Keerthi-2012/Audio-Amplifier/2023102012_2023112002_Table17.pdf

XXX-X-XXXX-XXXX-X/XX/$XX.00 ©20XX IEEE

# Audio Amplifier

KEERTHI SEELA
2023102012
IIIT HYDERABAD
keerthi.seela@students.iiit.ac.in

ANUMULA VENKATA SAI SREE
SAHITHI
2023112002
IIIT HYDERABAD
sahithi.anumula@research.iiit.ac.in

Abstract—This project aims to design and implement an audio amplifier with the given specifications, performance criteria. The amplifier consists of four main stages: preamplification, gain stage, filtering, and power amplification. The pre-amplifier is designed using a differential common-emitter configuration to ensure high input impedance and minimize noise. The gain stage employs a common-emitter amplifier to achieve the required amplification. A band-pass filter is incorporated to limit unwanted frequency components while maintaining signal integrity. The power amplifier, implemented as a Class AB design, ensures efficient power delivery with minimal distortion. The project also includes an analysis of distortion and slew rate to evaluate signal quality and circuit performance. The total harmonic distortion (THD) is minimized using filtering techniques, while the slew rate is optimized to handle high-frequency signals effectively. The final design provides a robust and efficient audio amplification system suitable for various applications.

Keywords—component, formatting, style, styling, insert (key words)

I. INTRODUCTION
Amplifiers are essential in modern audio systems, ensuring weak signals are amplified without significant distortion. An ideal audio amplifier should not only increase signal strength but also maintain clarity, efficiency, and minimal noise. This project explores the design and implementation of an audio amplifier tailored for low-power applications while meeting key performance criteria.

The amplifier design is structured into multiple stages, each playing a critical role in enhancing the input signal. The pre-amplifier boosts the weak audio signal while maintaining a high signal-to-noise ratio. The gain stage provides the necessary amplification, while a band-pass filter ensures that only the desired frequency range (20 Hz–20 kHz) is retained. The final stage, a Class AB power amplifier, delivers sufficient power to drive the output without introducing significant distortion.

II. SPECIFICATIONS
The audio amplifier is designed to meet the following technical specifications:
- Supply Voltage: 0–5V
- Input Signal Voltage: 10–40mV (peak-to-peak)
- Voltage Gain: 500 (achieved through preamplification and gain stages)
- Frequency Response: 20 Hz to 20 kHz (audible frequency range)
- Output Power: 1.5W
- Filter Design: Must preserve the input signal without attenuation
- Power Amplifier Constraint: Should not introduce additional voltage gain
- Load Resistance: 10Ω
These specifications ensure that the amplifier effectively enhances low-level audio signals while maintaining signal integrity, minimizing distortion, and optimizing power efficiency.
template for your paper size. This template has been tailored for output on the A4 paper size. If you are using US letter-sized paper, please close this file and download the Microsoft Word, Letter file.

III. PRE-AMPLIFIER
A pre-amplifier (preamp) is the first stage in an audio amplifier system. Its main function is to increase the strength of a weak input signal so that it can be further amplified without distortion. In this project, the preamp is designed to handle input signals between 10–40mV peak-topeak while minimizing noise.
To ensure proper operation, the preamp should have a high input impedance to avoid drawing too much current from the signal source and a low output impedance to efficiently transfer the signal to the next stage. A common-emitter differential amplifier is chosen for its ability to provide high gain and reduce unwanted noise. Proper transistor biasing is necessary to keep the amplifier in its active region and prevent signal distortion.
A well-designed preamp helps maintain signal clarity by reducing interference and ensuring the input signal is amplified without unwanted modifications. Once the preamp boosts the signal, it is sent to the next stage for further amplification.

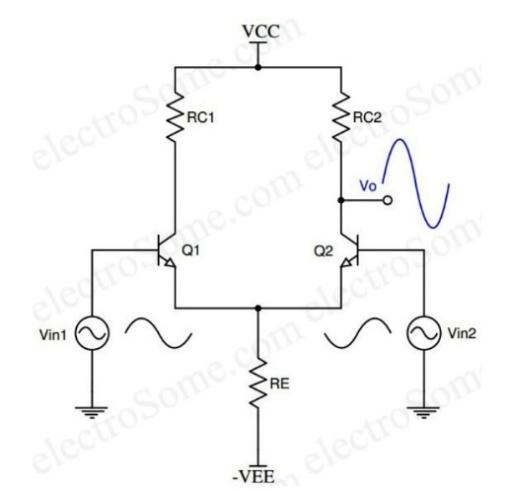
[picture p1: figure]

Figure: Pre-Amplifier

The differential amplifier is a fundamental building block in analog electronics, widely used in operational amplifiers and signal processing applications. It amplifies the difference between two input signals while rejecting common-mode noise. This report analyzes the working of a differential amplifier when one of its inputs Vin2 is grounded.
The circuit consists of two identical NPN transistors Q1 and Q2 with a common emitter resistor RE. The collectors are connected to the power supply VCC via resistors RC1 and RC2, and the output voltage Vo is taken from the collector of Q2. The input signals Vin1 and Vin2 are applied at the bases of the transistors, and the circuit operates with a negative power supply -VEE at the emitter resistor.
Biasing and DC Operation:
When Vin2=0 (grounded), the base-emitter voltage of Q2 is determined as:

VE = VB2 -VBE2 = 0V - 0.7V = -0.7V

The emitter current IE is given by:

IE = |VE- (-VEE) | / RE

Since IE is shared between Q1 and Q2,

IE1 + IE2 = IE

where IE1 and IE2 are the emitter currents of Q1 and Q2, respectively.

Effect of Input Voltage Vin1 on Transistor Currents:
When Vin1 increases:
- The base-emitter voltage VBE1 of Q1 increases, leading to an increase in IE1.
- Since the total emitter current IE remains nearly constant, an increase in IE1 results in a decrease in IE2.
- Since collector current IC is approximately equal to the emitter current in active mode, we get:
Output Voltage Behavior:
The output voltage Vo is taken from the collector of Q2 and is given by:
Vo = VCC - IC2 RC

As IC2 decreases with an increasing Vin1, the voltage drop across RC decreases, leading to an increase in Vo. This indicates that the circuit behaves as an inverting amplifier.

Voltage Gain of the Amplifier:
The voltage gain Av of the amplifier is determined by the transconductance gm and collector resistance RC:

gm = IC/ VT, Av = gm RC

where VT is the thermal voltage VT = 25mV at room temperature.

When Vin2 is grounded, the differential amplifier functions as a single-ended inverting amplifier. The output voltage increases when the input Vin1 increases, and the voltage gain depends on the transconductance and the collector resistance. This configuration is widely used in differential signal processing and operational amplifier designs.

Applications:
- Operational amplifier input stages
- Signal amplification and processing
- Common-mode noise rejection
- Comparator circuits

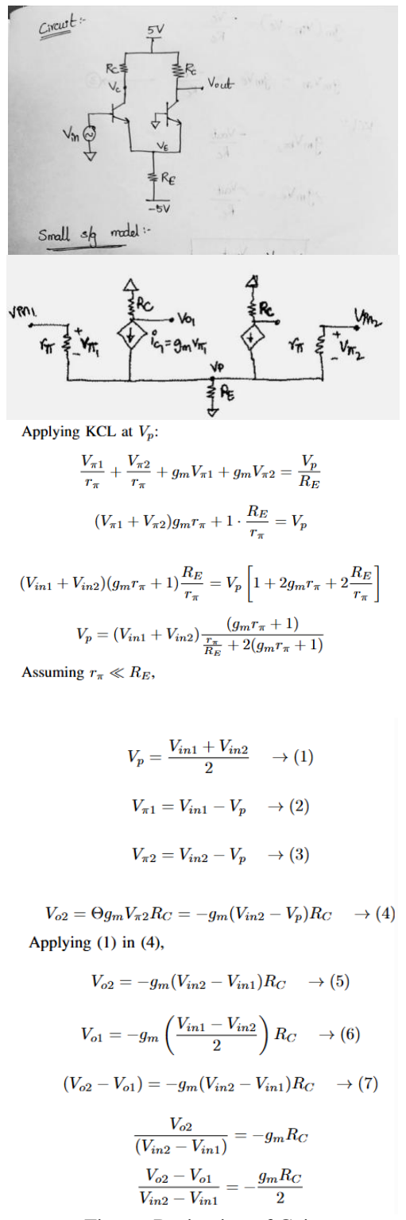
[picture p2: figure]

Figure: Derivation of Gain

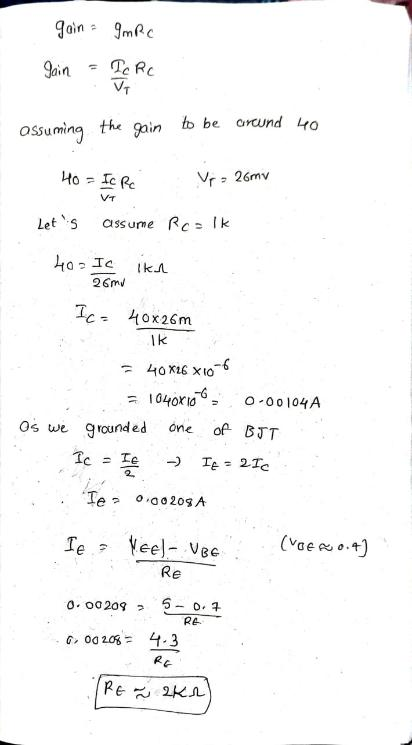
[picture p3: figure]

Figure: Calculations for pre-amplifier

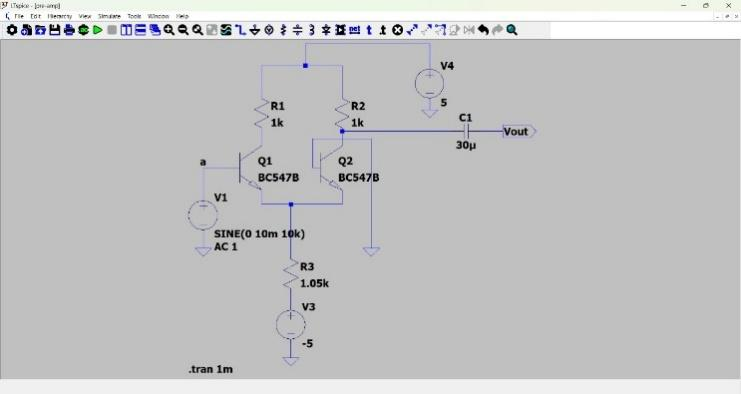
[picture p4: figure]

Figure: Circuit Diagram

Figure: LTSPICE Output

Figure: Bode plot

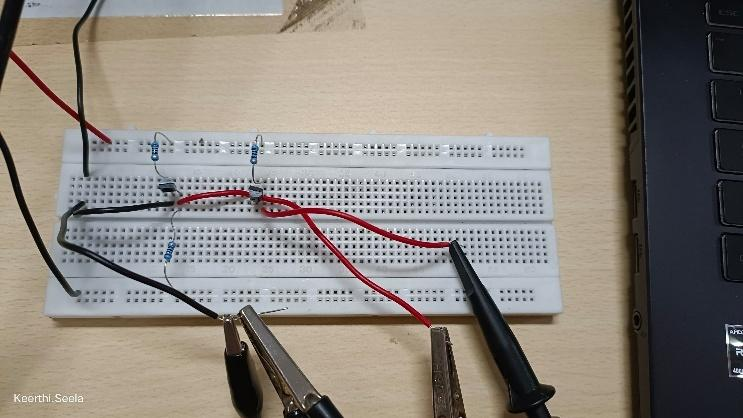
[picture p5: figure]

Figure: Hardware

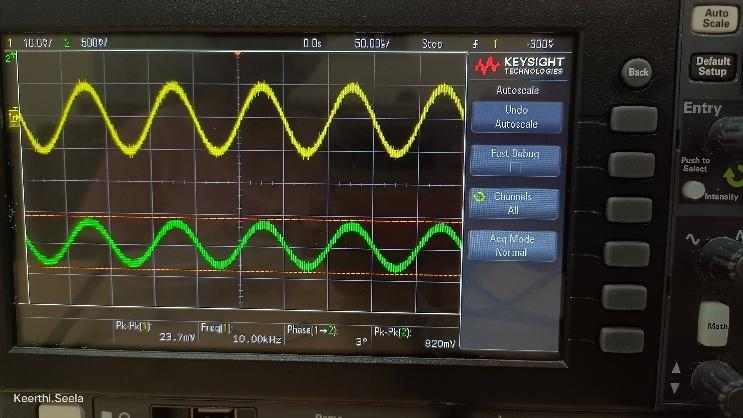
[picture p6: figure]

Figure: Hardware Output
Hardware Gain of preamp stage = 820 mV/20mV =41

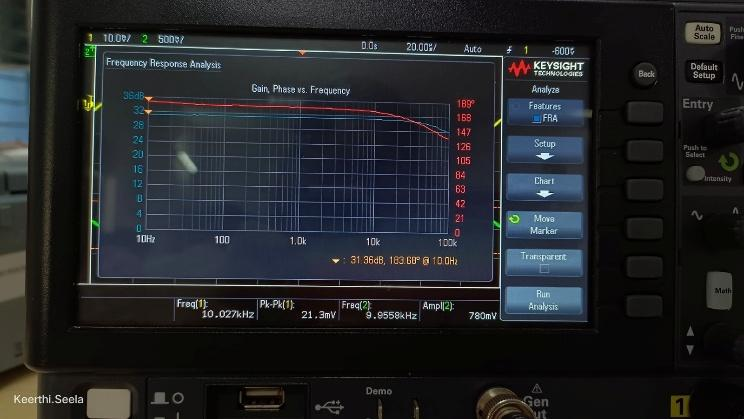
[picture p7: figure]

Figure: Hardware Bode Plot

Common mode Rejection Ratio:
Common-Mode Rejection Ratio (CMRR) is a measure of a differential amplifier’s ability to reject common-mode signals (noise) while amplifying differential signals. A higher CMRR indicates better noise rejection, making the amplifier more effective in reducing interference. The mathematical expression for CMRR is given by:
CMRR =

Ad

ACM
where:
- Ad = Differential Gain (gain for the desired signal)
- Acm = Common-Mode Gain (gain for noise or unwanted signals)
In decibels (dB), CMRR is expressed as:
CMRR(dB) = 20log10 (

|Ad

|Acm|

)

Example: (CMRR = 10,000)
If CMRR is 10,000, it means the amplifier amplifies the differential signal 10,000 times more than the unwanted noise.
In decibels:
CMRR = 20 log10(10, 000) = 80 dB
This indicates that the amplifier significantly reduces noise and interference, ensuring clean signal amplification. Stability Factor in Audio Amplifiers:
The stability factor in audio amplifiers measures how stable the amplifier is against changes in parameters, particularly temperature variations and component aging. It is crucial because unstable amplifiers can lead to unwanted effects like thermal runaway, oscillations, or distorted output.
a) Definition: The stability factor (S) quantifies how
much the collector current (IC) changes with changes in current gain (β). It is commonly defined as:

S =

dIC
dβ
The ideal value of S is 1, which indicates no change in collector current despite variations in β. Higher values indicate less stability.
Stability Important in Audio Amplifiers because:
- Temperature Variations:
- Amplifiers generate heat during operation, causing changes in transistor parameters, especially (β).
- A high stability factor can cause thermal runaway, leading to distorted audio output or damage to the amplifier.
- Component Aging:
- As components age, their parameters may change, particularly transistors and capacitors.
- An amplifier with a low stability factor is more robust against these changes.
- Feedback and Stability:
- Audio amplifiers often use negative feedback to improve stability and reduce distortion.
- Proper feedback design reduces the sensitivity of the output to variations in transistor parameters.

IV. GAIN STAGE
The gain stage is responsible for further amplifying the signal received from the pre-amplifier to achieve the required total gain of 500. This stage must be designed carefully to ensure signal integrity while minimizing distortion and instability.
A common-emitter (CE) amplifier is used due to its high voltage and current gain. It has a low input impedance, allowing efficient signal reception, and a high output impedance, making it suitable for driving the next stage.

To ensure stable operation, biasing resistors keep the transistor in its active region, preventing signal distortion. Coupling capacitors remove unwanted DC components, allowing only AC signals to pass. Additionally, proper impedance matching is necessary to ensure efficient signal transfer between stages, preventing signal loss and unwanted reflections that could degrade performance.

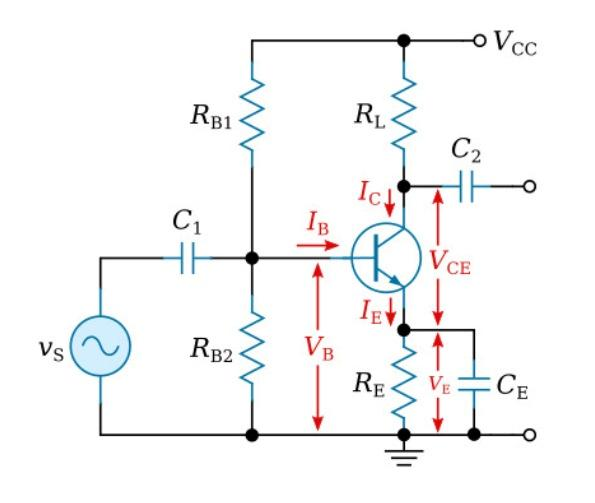
[picture p8: figure]
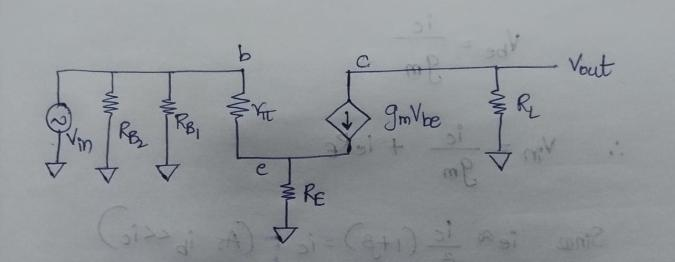
[picture p9: figure]

Figure: CE-Amplifier

Key Components of CE Amplifier:

The CE amplifier consists of the following key components:

- Biasing Resistors (RB1, RB2):
- Provide proper DC biasing to set the transistor's operating point.
- Emitter Resistor (RE):
- Stabilizes the operating point and improves linearity.
- Collector Resistor (RL):
- Converts the amplified current into an output voltage.
- Coupling Capacitors (C1, C2):
- Block DC and allow AC signals to pass.
- Bypass Capacitor (CE):
- Enhances gain by bypassing AC signal currents around RE.
- Power Supply (VCC):
- Provides the necessary operating voltage. Input and Output Impedance:
The CE amplifier exhibits moderate input impedance (typically 1-10 k) and relatively high output impedance (10-50 k).The input impedance is given by:
Zin = RB || (hie + (1 + hfe)R’E ) And the output impedance is approximately:
Zout ≈ RC

Operating Principle:
The CE amplifier operates in the active region of the transistor, ensuring amplification. The working mechanism is as follows:

### 1. DC Biasing:

The resistors RB1 and RB2 form a voltage divider network to set the base voltage (VB). The emitter voltage is given by:
VE = VB - VBE
where VBE ≈ 0.7V for a silicon transistor.
The collector-emitter voltage is:
VCE = VCC - ICRL - IERE

### 2. Signal Amplification:

When an AC input signal (vS) is applied, it modulates the base voltage (VB). A small increase in VB results in a larger increase in collector current (IC) due to transistor current gain (β). This increased IC causes a larger voltage drop across RL, leading to an inverted and amplified output voltage at the collector.

### 3. Voltage Gain:

The voltage gain (Av) of the CE amplifier (without bypass capacitor CE) is:
Av = -gmRL / (1 + gmRE)

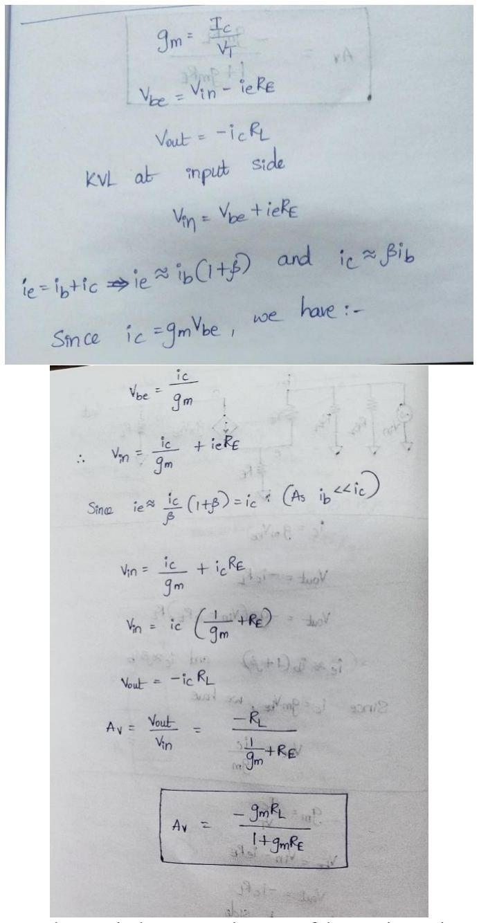
[picture p10: figure]

where gm is the transconductance of the transistor, given by:
gm = IC / VT, (where VT ≈ 25mV at room temperature)
If CE is present, the gain simplifies to:
Av ≈ -gmRL

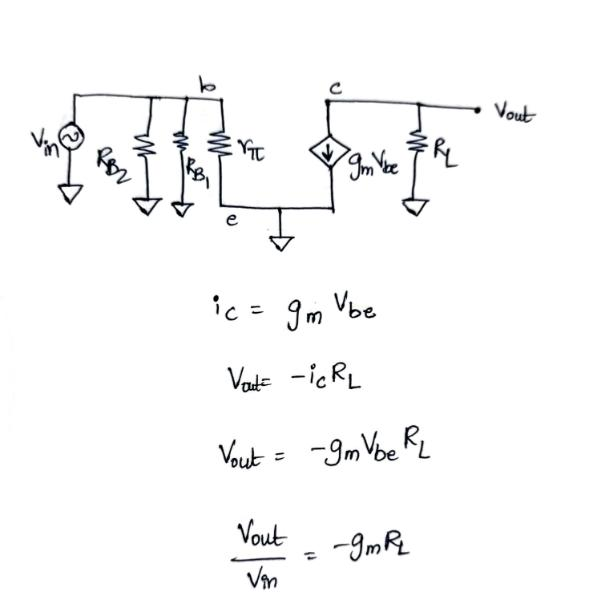
[picture p11: figure]

### 4. Phase Relationship

The CE amplifier inverts the phase of the input signal, meaning that the output is 180° out of phase with the input.

### 5. Frequency Response

- Low-Frequency Response: Limited by coupling capacitors (C1, C2) and bypass capacitor (CE).
- Midband Response: The amplifier operates with stable gain.
- High-Frequency Response: Limited by internal transistor capacitances.

Phase Inversion Happens in CE amplifier due to:
1. Base-Emitter Voltage (VBE) controls Collector current (IC)
- When the input signal at the base increases, the base-emitter voltage VBE also increases.
- This increases the base current IB, which in turn increases the collector current Ic (since Ic = ẞ IB, where ẞ is the current gain of the transistor).
2. Collector voltage drops due to increased current.
- The collector resistor Rc is connected to Vcc, and the voltage at the collector is given by:
Vc = Vcc - IcRc
- Since IC increases, the voltage drop across RC increases, which means the collector voltage Vc decreases.
3. Result: Output is Inverted
- If the input signal rises, the output voltage at the collector falls.
- If the input signal falls, the output voltage at the collector rises.
- This results in a 180° phase shift between input and output.

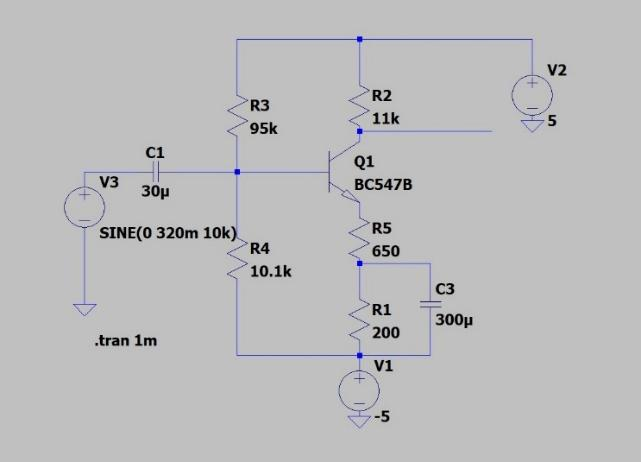
[picture p12: figure]

Figure: Circuit Diagram

Figure: LTSPICE Output

Figure: Bode Plot

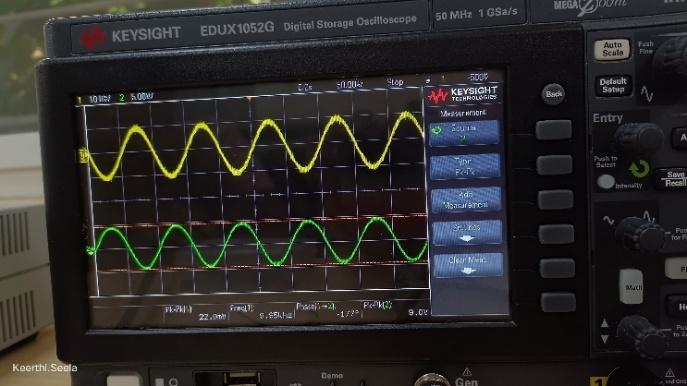
[picture p13: figure]

Figure: Hardware Output

Total Gain = 9V / 20mV=450

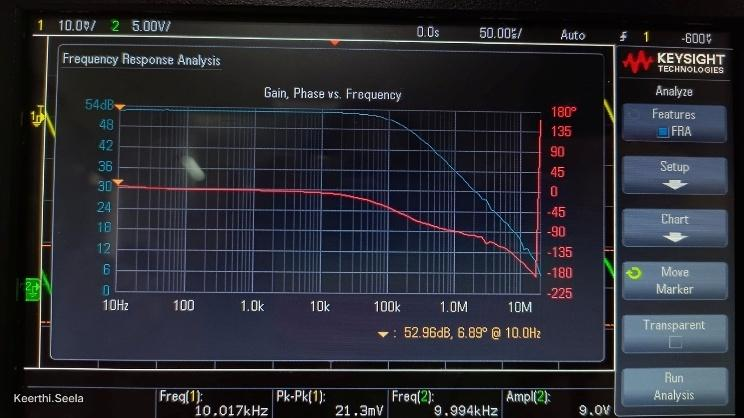
[picture p14: figure]

Figure: Bode Plot

V. FILTER STAGE
The filter stage is responsible for shaping the frequency response of the amplifier by allowing only the desired range of frequencies to pass while blocking unwanted signals. In this project, the filter ensures that the amplifier operates effectively within the audible frequency range of 20 Hz to 20 kHz without attenuating the input signal.

A band-pass filter is commonly used in audio applications to remove low-frequency noise (such as DC offsets) and high-frequency interference that could distort the output. This filter consists of a combination of capacitors and resistors, which define the cutoff frequencies and determine the overall response of the system.

To ensure stable and regulated power supply to various circuit components, a voltage regulation system is implemented. The filter stage operates with a ±12V power supply, which is then regulated to ±5V using a voltage regulator. This regulated voltage is supplied to other stages of the amplifier, ensuring consistent operation and preventing fluctuations that could impact performance.

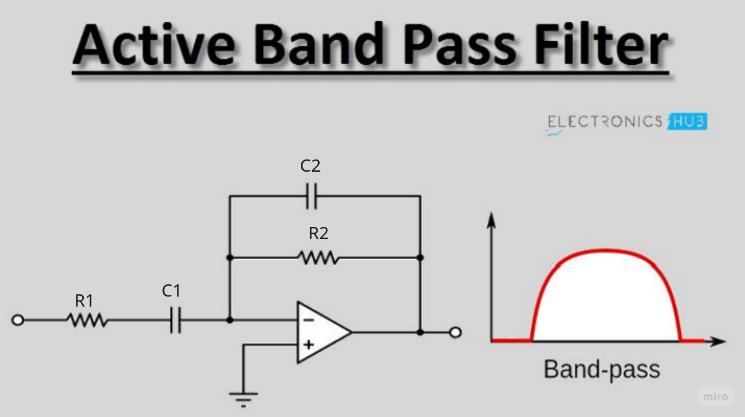
[picture p15: figure]

Figure: Band pass filter
Working principle:
1) Input RC Network (High-Pass Filter):
The first RC network at the input acts as a high pass filter, blocking low-frequency components below its cutoff frequency(fL) and allowing higher frequencies to pass.
2) Feedback RC Network (Low-Pass Filter):
The second RC network in the feedback loop acts as a low-pass filter, allowing frequencies below its cutoff frequency (fH) to pass while attenuating higher frequencies.
3) Band-Pass Filtering:
The combination of the two RC networks results in a band-pass filter, allowing frequencies within the band (fL < f < fH) to pass while attenuating frequencies outside this range.

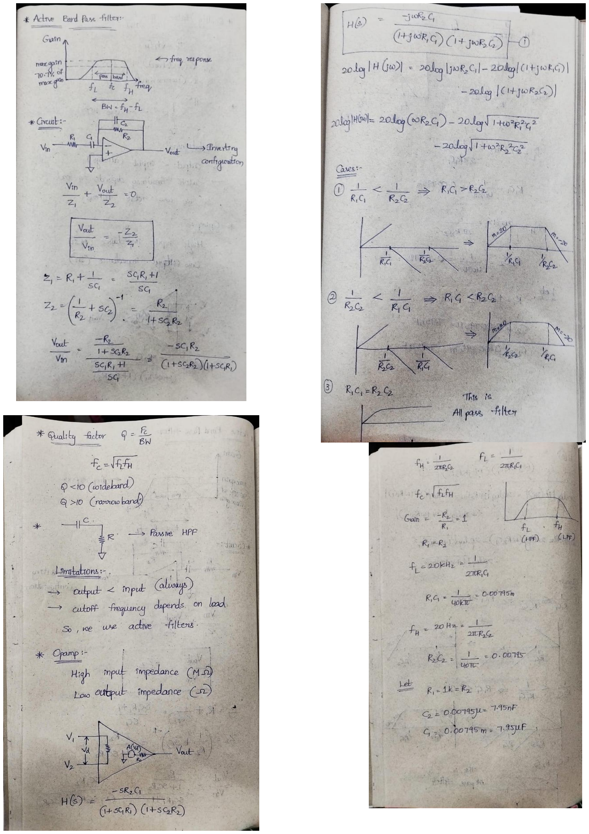
[picture p16: page 7]

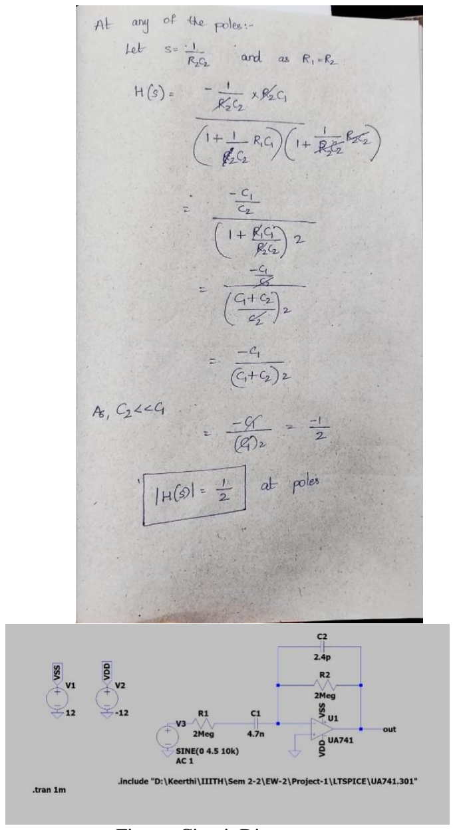
[picture p17: figure]

Figure: Circuit Diagram

Figure: LTSPICE Output

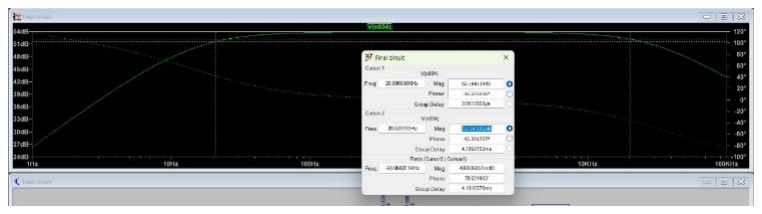
[picture p18: figure]

Figure: Bode Plot

Figure: Hardware Output

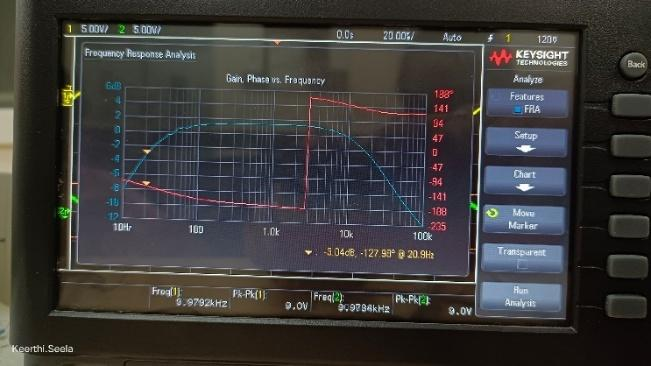
[picture p19: figure]

Figure: Frequency Response at 20 Hz

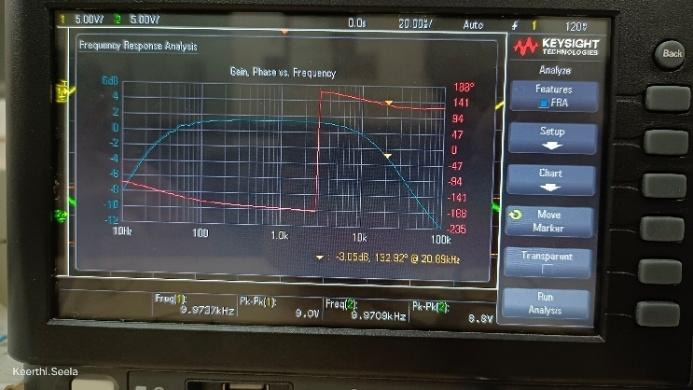
[picture p20: figure]

Figure: Frequency Response at 20 kHz

VI. POWER AMPLIFIER
The power amplifier is the final stage of the audio amplification system, responsible for delivering sufficient power to drive the output load without introducing distortion. Unlike previous stages that focus on voltage amplification, the power amplifier is designed to provide the necessary current and power gain while maintaining signal integrity. In this project, a Class AB power amplifier is used due to its efficiency and low distortion characteristics. Class AB amplifiers combine the advantages of Class A (low distortion) and Class B (high efficiency) amplifiers, ensuring better performance for audio applications. The design ensures that the amplifier does not introduce additional voltage gain while efficiently driving the 10Ω load.
Class-A Power Amplifier:
- Operating Principle: The transistor in a Class-A amplifier is biased so that it remains active (in the linear region) throughout the entire input signal cycle (360◦ conduction angle).
- Features:
– High linearity, making it suitable for low-distortion amplification.
– Poor efficiency, typically around 25% − 30%.
– High heat dissipation due to continuous current flow even without input signal.

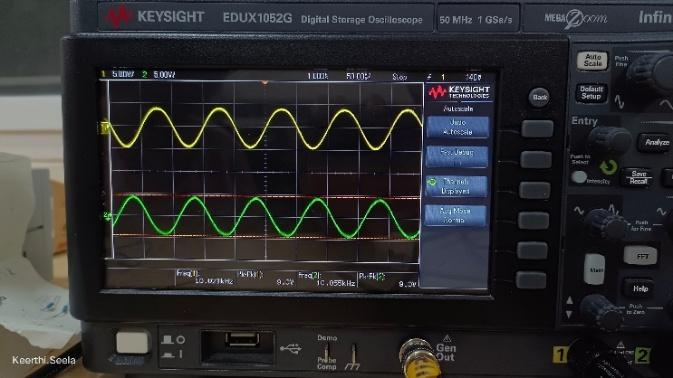
[picture p21: figure]
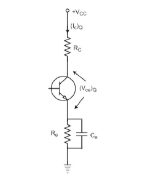
[picture p22: figure]

Figure: Class A amplifier
Class-B Power Amplifier:
- Operating Principle: The transistor is biased at cutoff, and each transistor in a push-pull configuration conducts for half of the input signal cycle (180◦ conduction angle).
- Features:
– Higher efficiency compared to Class-A, typically around 50% − 70%.
– Introduces crossover distortion due to the transition between transistors.
– Requires a complementary pair of transistors (NPN and PNP or MOSFETs).

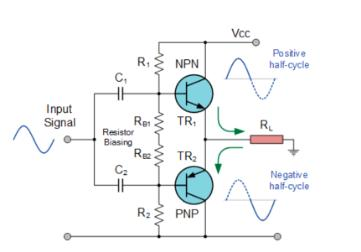
[picture p23: figure]

Figure: Class B amplifier

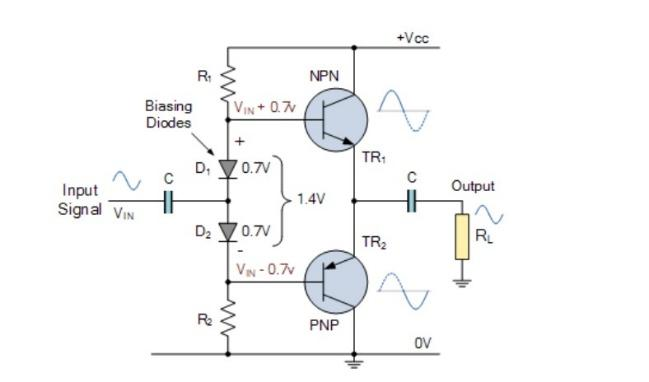
[picture p24: figure]

Figure: Class AB Power Amplifier

Working of Class AB Power Amplifier:
A small constant current flows through the series circuit of R1-D1-D2-R2, producing voltage drops which are symmetrical either side of the input. With no input signal voltage applied, the point between the two diodes is zero volts. As current flows through the chain, there is a forward bias voltage drop of approximately 0.7V across the diodes which is applied to the base-emitter junctions of the switching transistors.
Therefore, the voltage drop across the diodes, biases the base of transistor TR1 to about 0.7 volts, and the base of transistor TR2 to about –0.7 volts. Thus, the two silicon diodes provide a constant voltage drop of approximately 1.4 volts between the two bases biasing them above cut-off.

As the temperature of the circuit rises, so too does that of the diodes as they are located next to the transistors. The voltage across the PN junction of the diode thus decreases diverting some of the transistors base current stabilizing the transistors collector current.

If the electrical characteristics of the diodes are closely matched to that of the transistors base-emitter junction, the current flowing in the diodes and the current in the transistors will be the same creating what is called a current mirror. The effect of this current mirror compensates for variations in temperature producing the required Class AB operation thereby eliminating any crossover distortion.

In practice, diode biasing is easily accomplished in modern day integrated circuit amplifiers as both the diode and switching transistor are fabricated onto the same chip, such as in the popular LM386 audio power amplifier IC. This means that they both have identical characteristics curves over a wide temperature change providing thermal stabilization of the quiescent current.

The biasing of a Class AB amplifier output stage is generally adjusted to suit a particular amplifier application. The amplifiers quiescent current is adjusted to zero to minimize power consumption, as in Class B operation, or adjusted for a very small quiescent current to flow that minimizes crossover distortion producing a true Class AB amplifier operation.

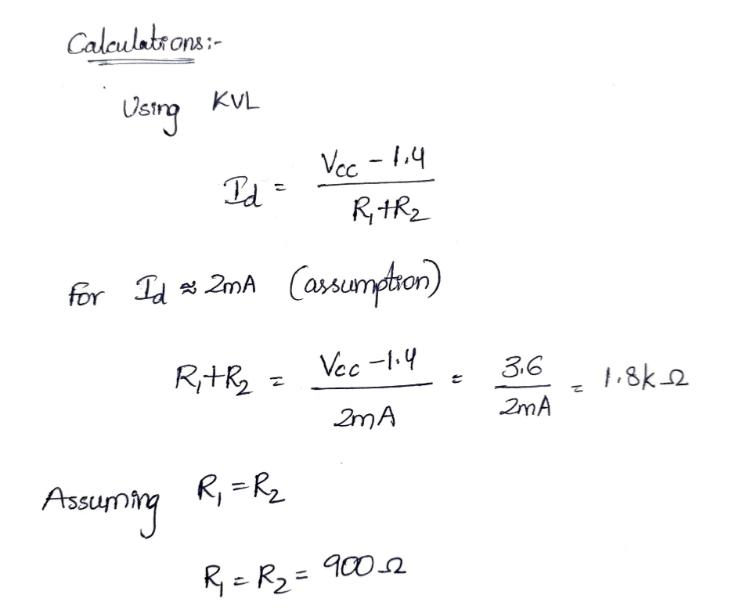
[picture p25: figure]

We chose 2mA Bias current because:
1. Reduced Crossover Distortion:
In a Class-AB amplifier, we slightly bias the transistors into conduction to avoid the dead zone where both transistors are off. A higher bias current (like 2mA) ensures that the transistors turn on smoothly, reducing crossover distortion.
2. Ensures Proper Operation of the Diodes:
Diodes require a small current to stay in conduction and maintain their 0.7V drop. At very low currents (<1mA), diodes may not operate consistently, leading to variations in base-emitter voltages (V be).
3. Faster response and Better Linearity:
A slightly higher bias current allows the transistors to switch on/off faster, improving the amplifier’s frequency response. It helps achieve better linearity in signal amplification.

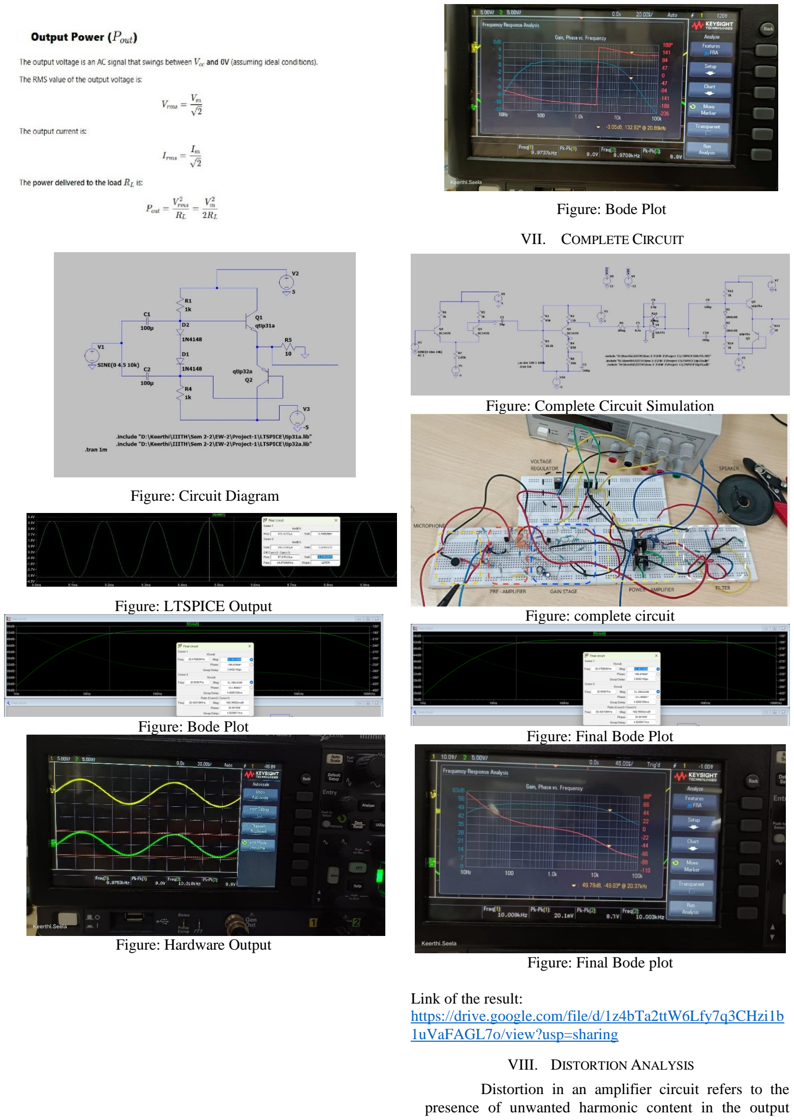
[picture p26: page 10]

Figure: Circuit Diagram

Figure: LTSPICE Output

Figure: Bode Plot

Figure: Hardware Output

Figure: Bode Plot

VII. COMPLETE CIRCUIT

Figure: Complete Circuit Simulation

Figure: complete circuit

Figure: Final Bode Plot

Figure: Final Bode plot

Link of the result:
https://drive.google.com/file/d/1z4bTa2ttW6Lfy7q3CHzi1b1uVaFAGL7o/view?usp=sharing (https://drive.google.com/file/d/1z4bTa2ttW6Lfy7q3CHzi1b1uVaFAGL7o/view?usp=sharing)

VIII. DISTORTION ANALYSIS
Distortion in an amplifier circuit refers to the presence of unwanted harmonic content in the output signal, which alters the original waveform. This can occur due to nonlinearities in the circuit components, leading to harmonic distortion. To quantify distortion, Total Harmonic Distortion (THD) is used:

THD =

√∑ | VnRMS
∞ | 2
n=2

VfRMS

VnRMS is the RMS Voltage of the nth harmonic VfRMS is the voltage of the fundamental frequency

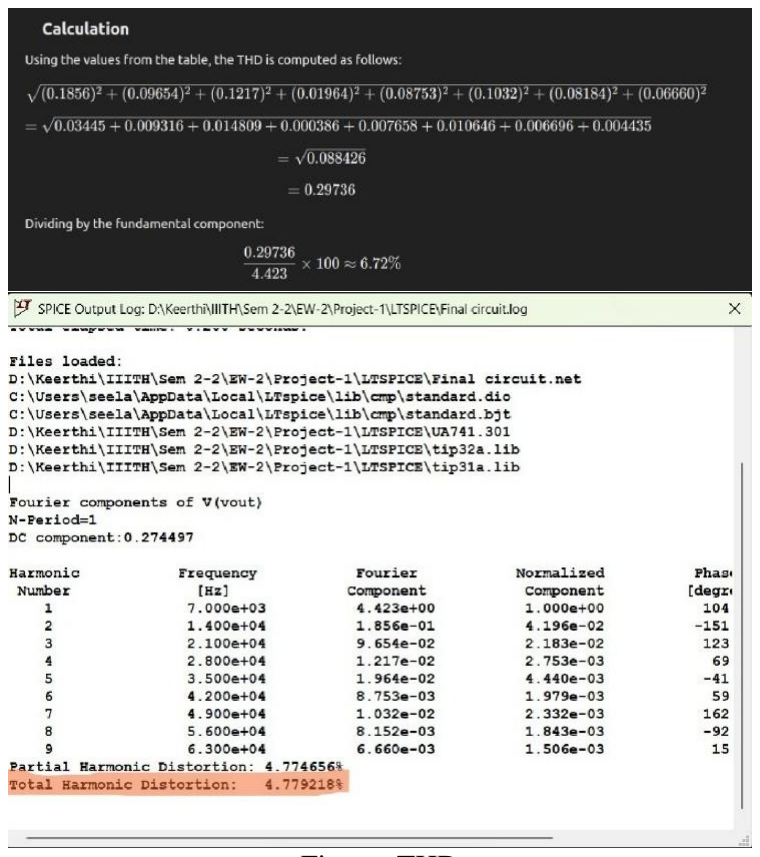
[picture p27: figure]

Figure: THD

The THD was determined using the Fast Fourier Transform (FFT) of the amplified output signal. A lower THD indicates minimal unwanted harmonics, resulting in better audio quality. High THD can lead to noticeable distortion, affecting the clarity and fidelity of the sound.
To reduce THD, low-pass filtering was applied to attenuate higher-order harmonics, minimizing circuit interference. Additionally, optimizing the biasing and feedback networks helped improve linearity, reducing unwanted distortions.

IX. SLEW RATE
The Slew Rate (SR) of an amplifier defines the maximum rate of change of the output voltage with respect to time:

S.R. = max (∂VOUT
| ∂t )

Figure: Slew rate
A high slew rate is desirable, ensuring the circuit can accurately reproduce high-frequency signals without distortion. If the slew rate is too low, the amplifier may fail to keep up with rapid voltage changes, resulting in slewinduced distortion, where sharp signal transitions appear rounded or delayed.
