Keerthi-2012/Audio-Amplifier/LTSPICE/Band pass filter.asc

C1: cap; 4.7n
C2: cap; 2.4p
R1: res; 2Meg
R2: res; 2Meg
U1: opamp2; UA741
V1: voltage; 12
V2: voltage; -12
V3: voltage; SINE(0 4.5 10k); AC 1
Named nets: 0, VSS, VDD, out
.include "UA741.301"
.tran 1m
