Keerthi-2012/Audio-Amplifier/LTSPICE/CE Amplifier.asc

C1: cap; 30µ
C3: cap; 300µ
Q1: npn; BC547B
R1: res; 200
R2: res; 11k
R3: res; 95k
R4: res; 10.1k
R5: res; 650
V1: voltage; -5
V2: voltage; 5
V3: voltage; SINE(0 320m 10k)
Named nets: 0
.tran 1m
