Keerthi-2012/Audio-Amplifier/LTSPICE/Final circuit.asc

C1: cap; 30µ
C2: cap; 300µ
C5: cap; 4.7n
C6: cap; 2.4p
C9: cap; 100µ
C10: cap; 100µ
D1: diode; 1N4148
D2: diode; 1N4148
Q1: npn; BC547B
Q2: npn; BC547B
Q3: npn; BC547B
Q4: npn; qtip31a
Q5: pnp; qtip32a
R1: res; 95k
R2: res; 11k
R3: res; 10.1k
R4: res; 650
R5: res; 1k
R6: res; 1k
R7: res; 1.05k
R8: res; 200
R9: res; 2Meg
R10: res; 2.Meg
R11: res; 1k
R12: res; 10
R14: res; 1k
U1: opamp2; UA741
V1: voltage; -5
V2: voltage; 5
V3: voltage; SINE(0 10m 7k); AC 1
V5: voltage; -5
V6: voltage; 5
V7: voltage; 5
V8: voltage; 12
V9: voltage; -12
V10: voltage; -5
Named nets: 0, VDD, VSS, a
;.ac dec 100 1 100k
.include "UA741.301"
.include "tip32a.lib"
.include "tip31a.lib"
.tran 1m
