Keerthi-2012/Audio-Amplifier/LTSPICE/Power Amplifier.asc

C1: cap; 100µ
C2: cap; 100µ
D1: diode; 1N4148
D2: diode; 1N4148
Q1: npn; qtip31a
Q2: pnp; qtip32a
R1: res; 1k
R4: res; 1k
R5: res; 10
V1: voltage; SINE(0 4.5 10k)
V2: voltage; 5
V3: voltage; -5
Named nets: 0
.include "tip31a.lib"
.include "tip32a.lib"
.tran 1m
