Keerthi-2012/Audio-Amplifier/LTSPICE/pre-amp.asc

C1: cap; 30µ
Q1: npn; BC547B
Q2: npn; BC547B
R1: res; 1k
R2: res; 1k
R3: res; 1.05k
V1: voltage; SINE(0 10m 10k); AC 1
V3: voltage; -5
V4: voltage; 5
Named nets: 0, Vout, a
.tran 1m
